eegan/Phys439-alpha-lab/README.md

# Phys439-alpha-lab
Arduino code and KiCAD schematic for McGill PHYS 439 lab setup
