eegan/Phys439-alpha-lab/doc/PHYS 439 alpha lab shield schematic.pdf

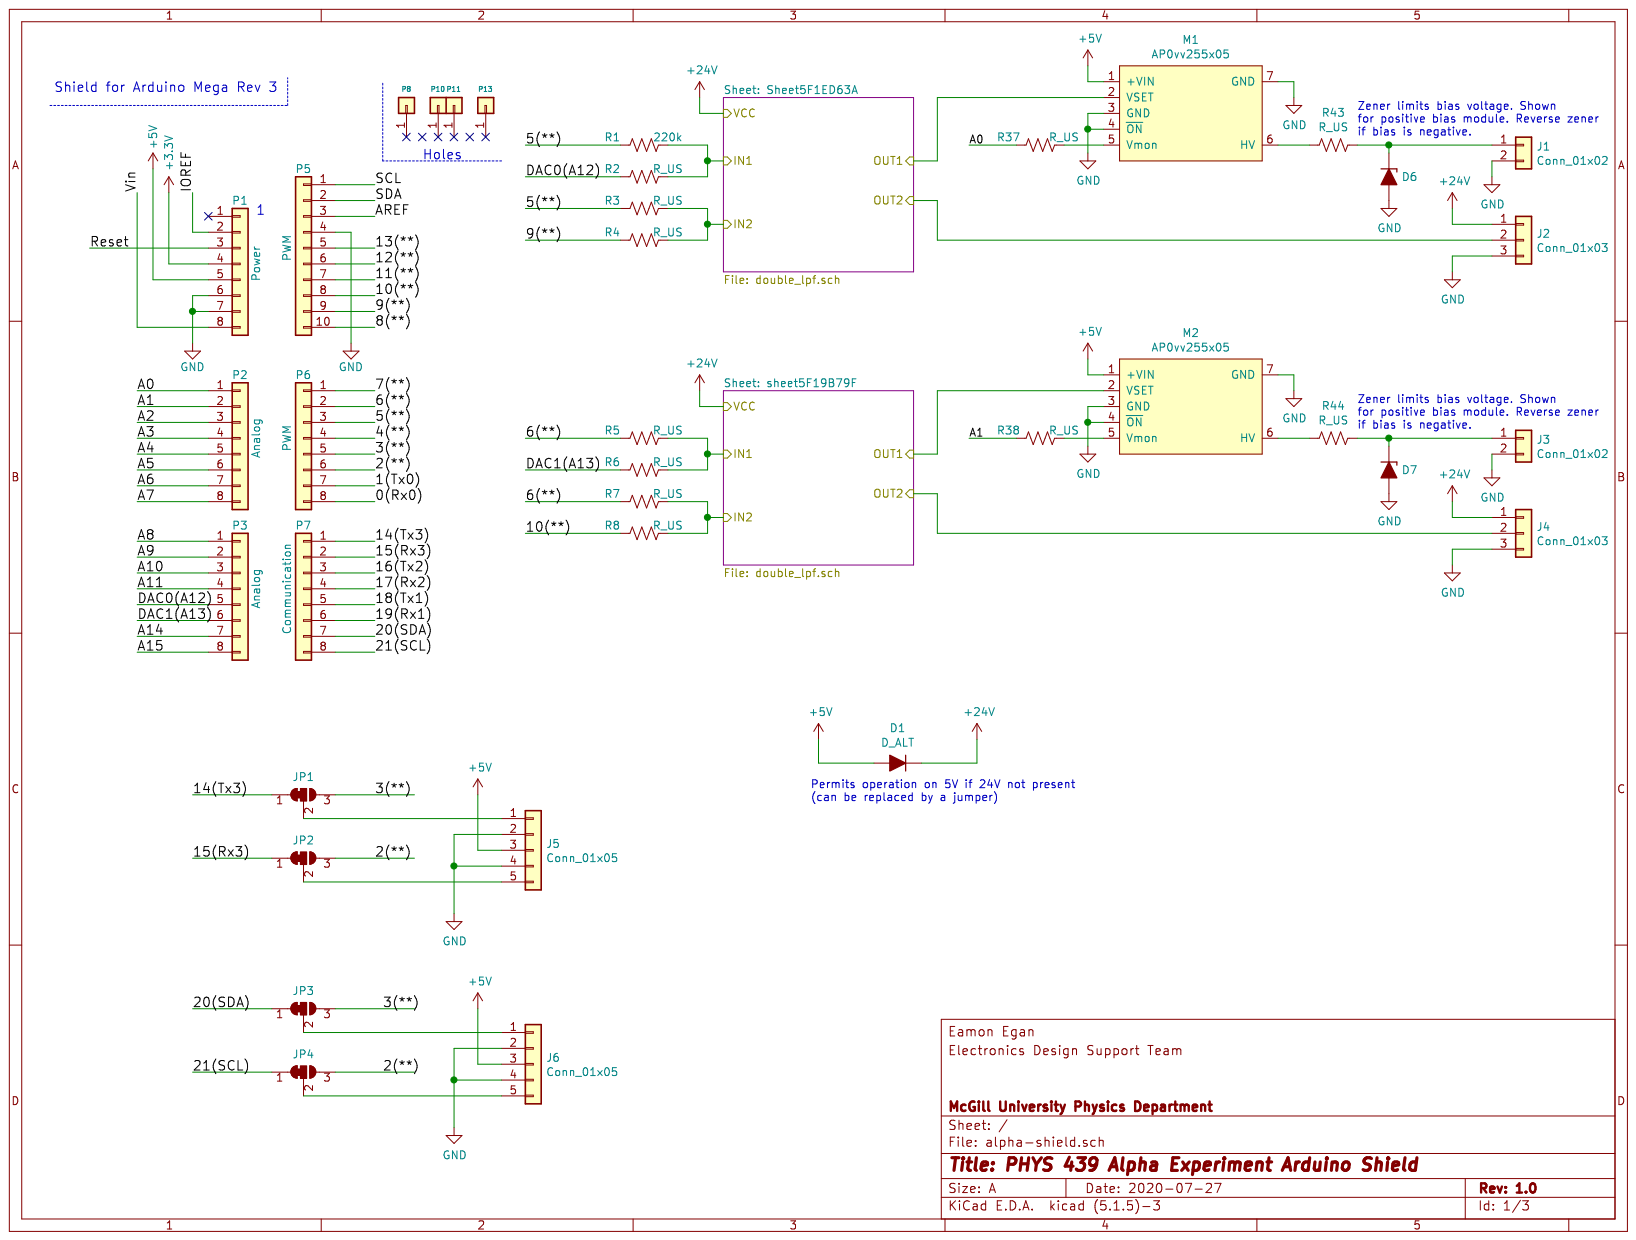
[picture p3: page 1]

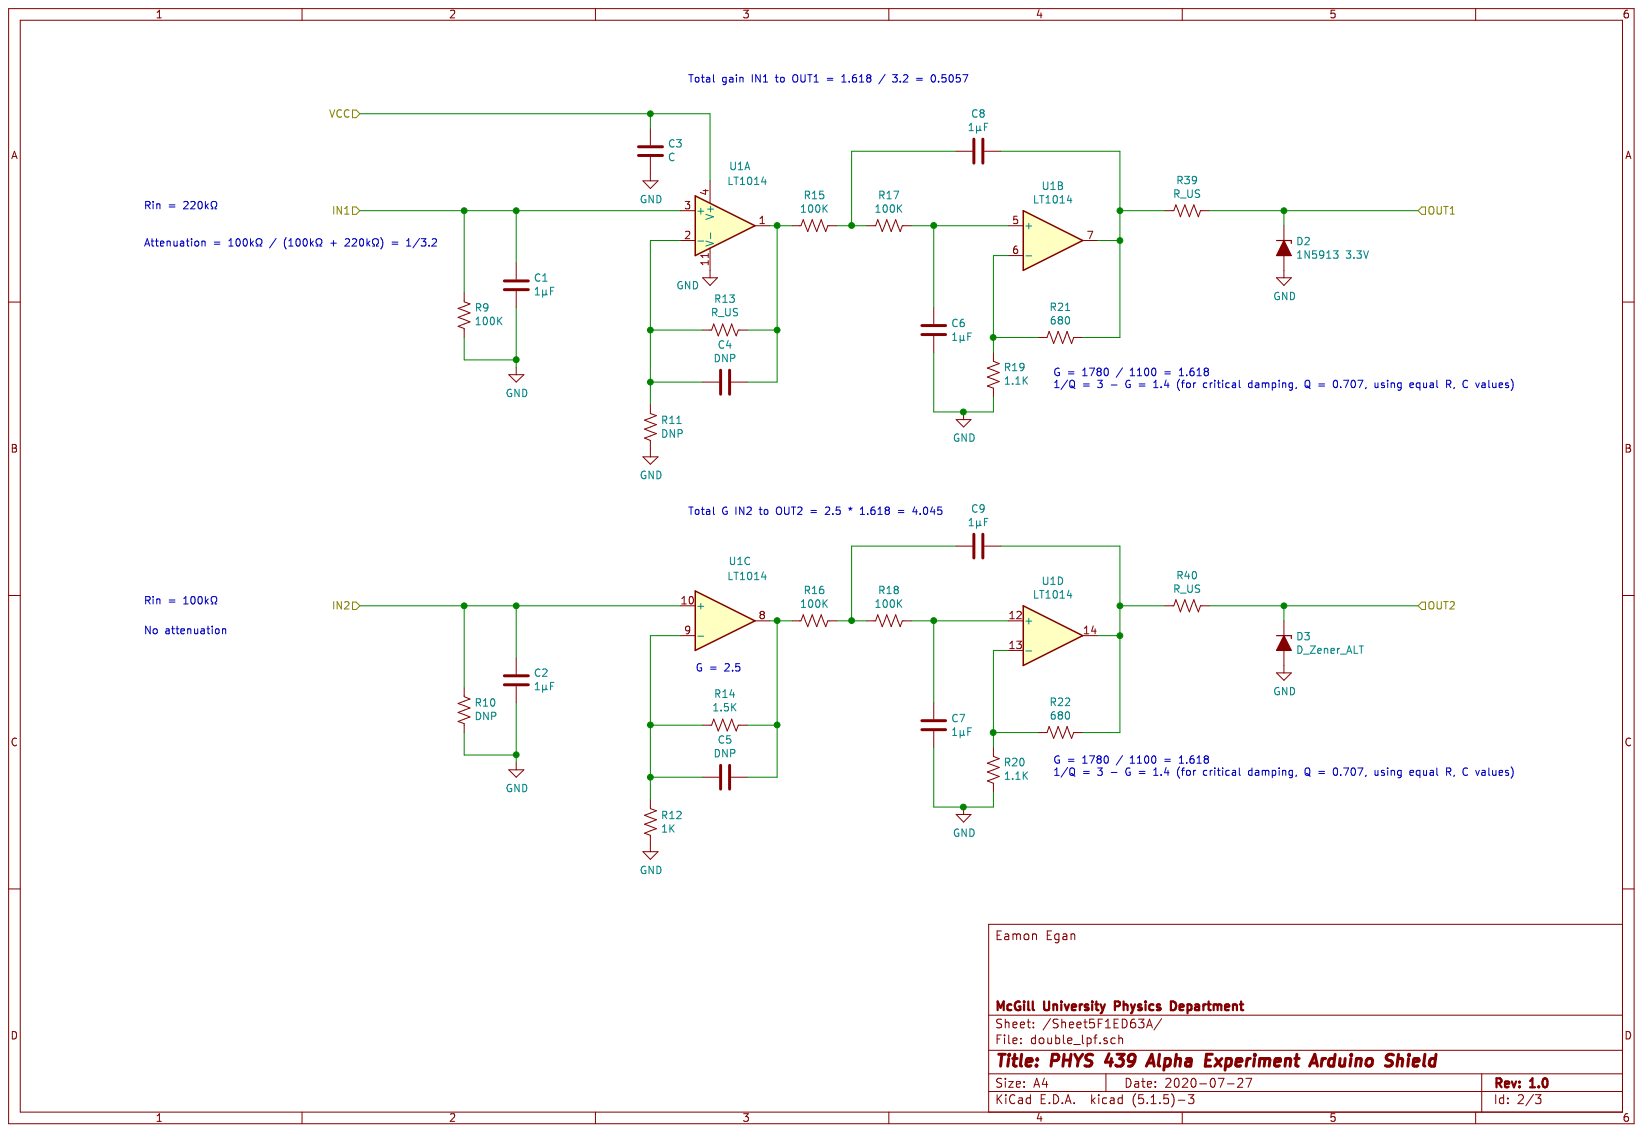
[picture p4: page 2]

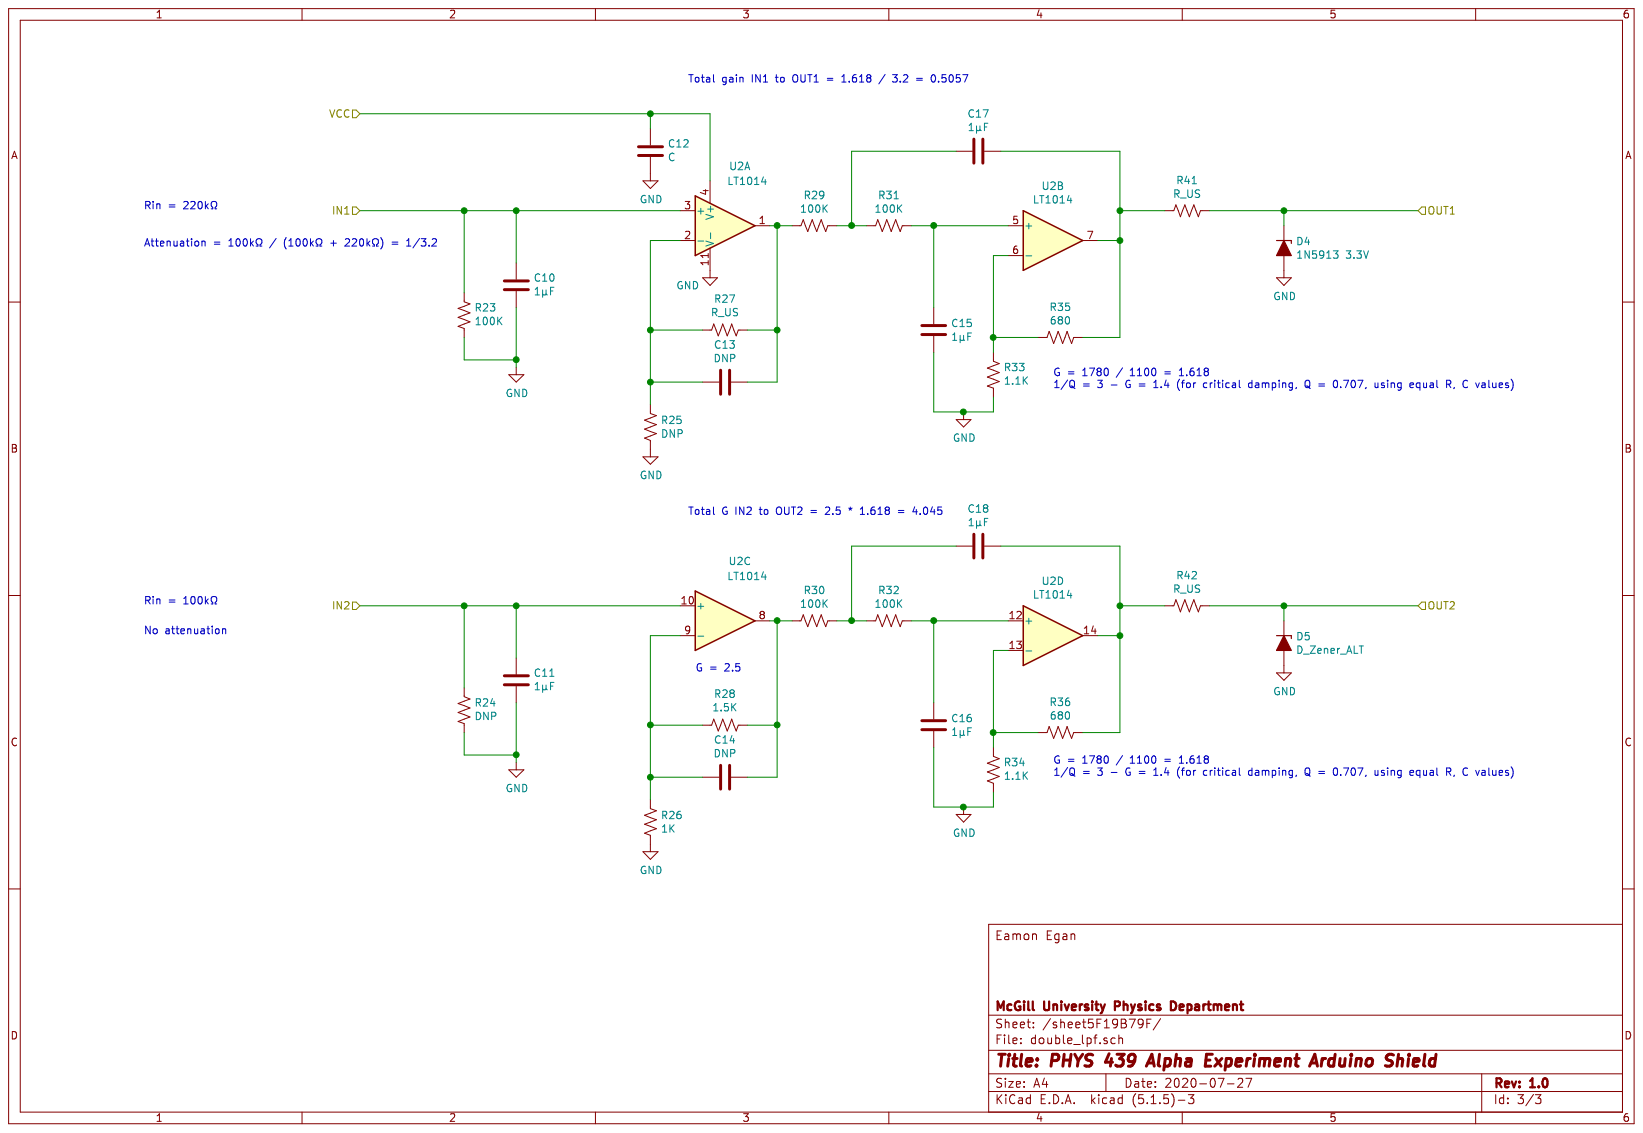
[picture p5: page 3]
