eegan/Phys439-alpha-lab/circuit/sim/PHYS439-alpha-filter.asc

C1: cap; 0
C2: cap; 1µF
C3: cap; {csk}
C4: cap; {csk}
R1: res; 1k
R2: res; 1G
R3: res; 220k
R4: res; 100k
R5: res; 1100
R6: res; 680
R7: res; {rsk}
R8: res; {rsk}
U1: LT1014D
U2: LT1014D
V1: voltage; 24
V2: voltage; 2; AC 1
Named nets: 0, out
.param csk=1u rsk=100k
.ac dec 500 0.1 1meg
.tran 5
