eegan/Phys439-alpha-lab/circuit/alpha-shield-pcb/alpha-shield.kicad_pcb

## KiCad design circuit/alpha-shield-pcb/alpha-shield.kicad_pcb (2020-08-14)

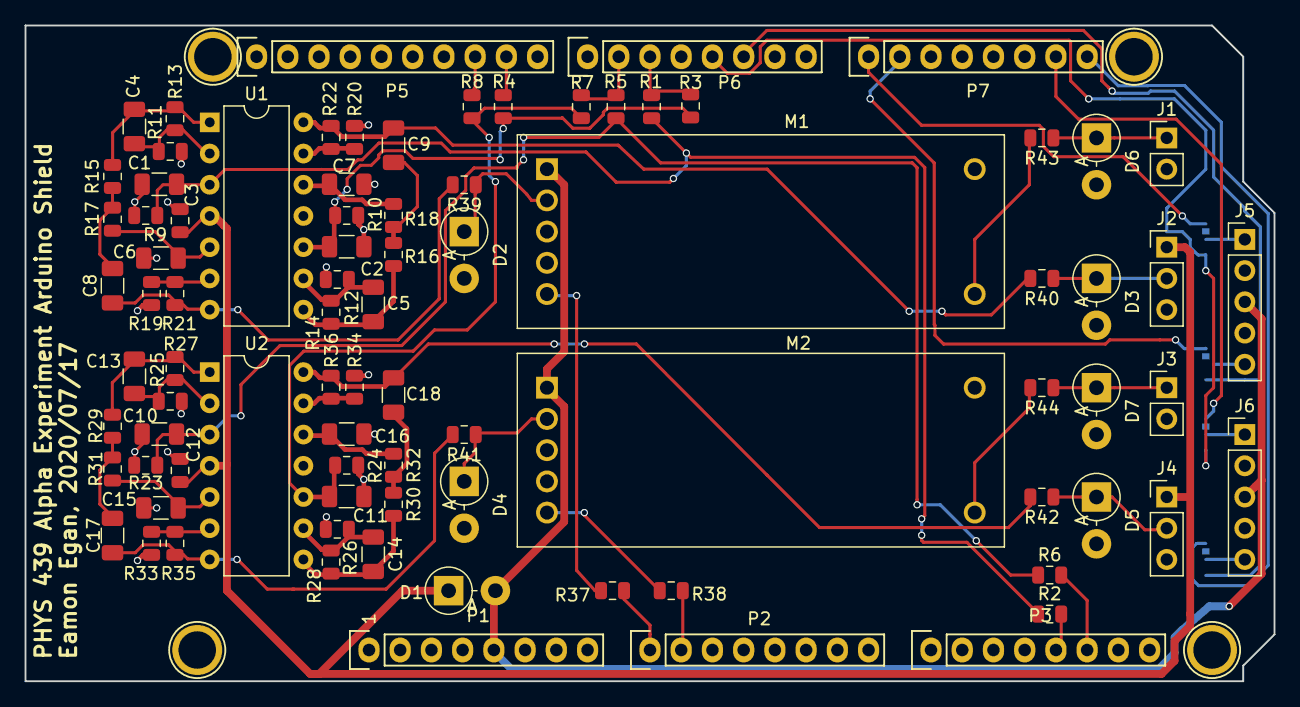
[picture p6: board alpha-shield.kicad_pcb from above]

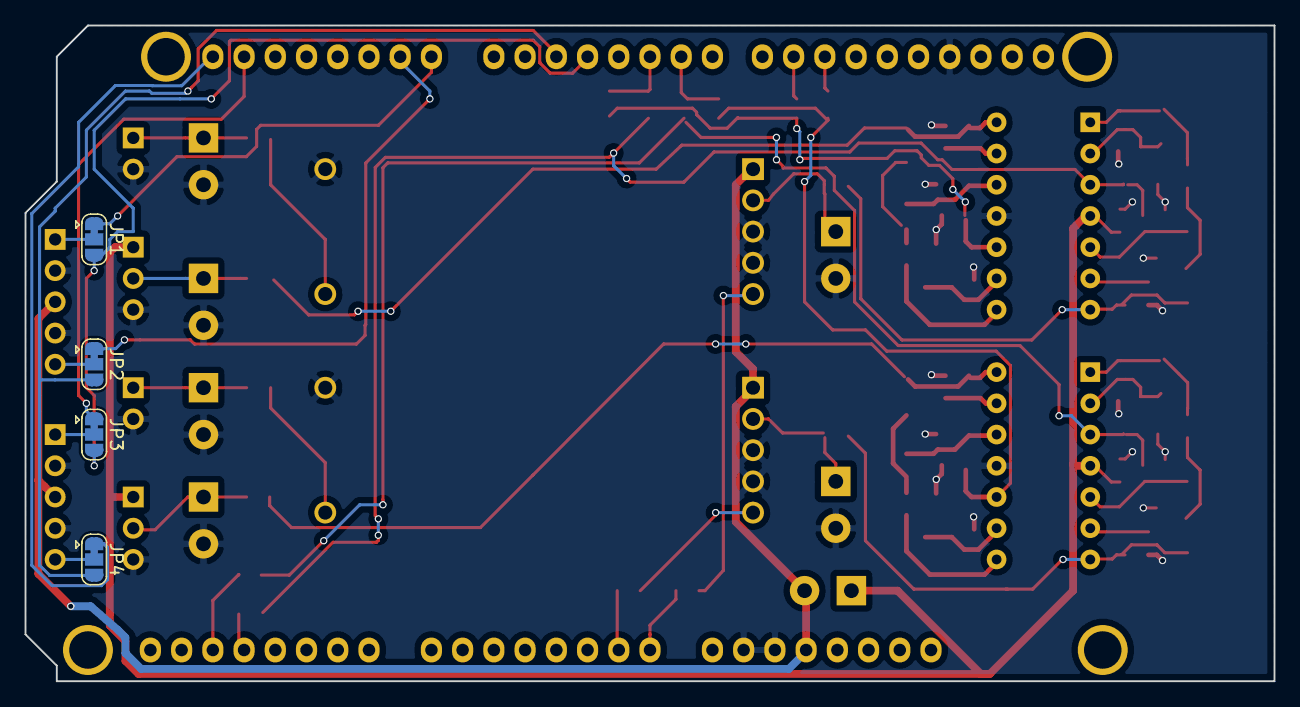
[picture p7: board alpha-shield.kicad_pcb from below]

Board: 2 copper layers, 101.6 x 53.3 mm, 93 parts (4 on the bottom side), 59 nets.

Parts:
C1, C2, C4, C5, C6, C7, C8, C9, C10, C11, C13, C14, C15, C16, C17, C18: C; C_1206_3216Metric
C3, C12: C; C_0805_2012Metric
D1: D_ALT; D_DO-15_P3.81mm_Vertical_AnodeUp
D2, D3, D4, D5, D6, D7: D_Zener_ALT; D_DO-15_P3.81mm_Vertical_AnodeUp
J1, J3: Conn_01x02; PinHeader_1x02_P2.54mm_Vertical
J2, J4: Conn_01x03; PinHeader_1x03_P2.54mm_Vertical
J5, J6: Conn_01x05; PinHeader_1x05_P2.54mm_Vertical
JP1, JP2, JP3, JP4: SolderJumper_3_Bridged12; SolderJumper-3_P1.3mm_Bridged12_RoundedPad1.0x1.5mm
M1, M2: AP0vv255x05; ISEG_HV_MODULE
P1: Power; Socket_Strip_Arduino_1x08
P2, P3: Analog; Socket_Strip_Arduino_1x08
P5: PWM; Socket_Strip_Arduino_1x10
P6: PWM; Socket_Strip_Arduino_1x08
P7: Communication; Socket_Strip_Arduino_1x08
P8, P10, P11, P13: CONN_01X01; Arduino_1pin
R1, R2, R3, R4, R5, R6, R7, R8, R9, R10, R11, R12, R13, R14, R15, R16, R17, R18, R19, R20, R21, R22, R23, R24, R25, R26, R27, R28, R29, R30, R31, R32, R33, R34, R35, R36, R37, R38, R39, R40, R41, R42, R43, R44: R_US; R_0805_2012Metric
U1, U2: LT1014; DIP-14_W7.62mm

Connections:
+5V: D1.2, J5.3, J6.3, M1.1, M2.1, P1.5
+24V: C3.2, C12.2, D1.1, J2.1, J4.1, U1.4, U2.4
/2(**): JP2.3, JP4.3, P6.6
/3(**): JP1.3, JP3.3, P6.5
/5(**): P6.3, R1.2, R3.2
/6(**): P6.2, R5.2, R7.2
/9(**): P5.9, R4.2
/10(**): P5.8, R8.2
/14(Tx3): JP1.1, P7.1
/15(Rx3): JP2.1, P7.2
/20(SDA): JP3.1, P7.7
/21(SCL): JP4.1, P7.8
/A0: P2.1, R37.2
/A1: P2.2, R38.2
/DAC0(A12): P3.5, R2.2
/DAC1(A13): P3.6, R6.2
/Sheet5F1ED63A/IN1: C1.2, R1.1, R2.1, R9.2, U1.3
/Sheet5F1ED63A/IN2: C2.2, R3.1, R4.1, R10.2, U1.10
/Sheet5F1ED63A/OUT1: D2.1, M1.2, R39.1
/Sheet5F1ED63A/OUT2: D3.1, J2.2, R40.1
/sheet5F19B79F/IN1: C10.2, R5.1, R6.1, R23.2, U2.3
/sheet5F19B79F/IN2: C11.2, R7.1, R8.1, R24.2, U2.10
/sheet5F19B79F/OUT1: D4.1, M2.2, R41.1
/sheet5F19B79F/OUT2: D5.1, J4.2, R42.1
GND: C1.1, C2.1, C3.1, C6.2, C7.2, C10.1, C11.1, C12.1, C15.2, C16.2, D2.2, D3.2, D4.2, D5.2, D6.2, D7.2, J1.2, J2.3, J3.2, J4.3, J5.2, J5.4, J6.2, J6.4, M1.3, M1.4, M1.7, M2.3, M2.4, M2.7, P1.6, P1.7, P5.4, R9.1, R10.1, R11.2, R12.2, R19.1, R20.1, R23.1, R24.1, R25.2, R26.2, R33.1, R34.1, U1.11, U2.11
unnamed: C4.1, R13.2, R15.2, U1.1
unnamed: C4.2, R11.1, R13.1, U1.2
unnamed: C5.1, R14.2, R16.2, U1.8
unnamed: C5.2, R12.1, R14.1, U1.9
unnamed: C6.1, R17.1, U1.5
unnamed: C7.1, R18.1, U1.12
unnamed: C8.1, R21.1, R39.2, U1.7
unnamed: C8.2, R15.1, R17.2
unnamed: C9.1, R22.1, R40.2, U1.14
unnamed: C9.2, R16.1, R18.2
unnamed: C13.1, R27.2, R29.2, U2.1
unnamed: C13.2, R25.1, R27.1, U2.2
unnamed: C14.1, R28.2, R30.2, U2.8
unnamed: C14.2, R26.1, R28.1, U2.9
unnamed: C15.1, R31.1, U2.5
unnamed: C16.1, R32.1, U2.12
unnamed: C17.1, R35.1, R41.2, U2.7
unnamed: C17.2, R29.1, R31.2
unnamed: C18.1, R36.1, R42.2, U2.14
unnamed: C18.2, R30.1, R32.2
unnamed: D6.1, J1.1, R43.1
unnamed: D7.1, J3.1, R44.1
unnamed: J5.1, JP1.2
unnamed: J5.5, JP2.2
unnamed: J6.1, JP3.2
unnamed: J6.5, JP4.2
unnamed: M1.5, R37.1
unnamed: M1.6, R43.2
unnamed: M2.5, R38.1
unnamed: M2.6, R44.2
unnamed: R19.2, R21.2, U1.6
unnamed: R20.2, R22.2, U1.13
unnamed: R33.2, R35.2, U2.6
unnamed: R34.2, R36.2, U2.13
