eegan/Phys439-alpha-lab/(commit log)

2020-07-30 Adapt it to the Due, use only 12 bit PWMs
2020-08-02 setting calculations fixed to include 3.3V VCC and calculated circuit gains.
    [alpha-shield.ino]
2020-08-03 Debug relays
2020-08-03 modify README to reference KiCAD schematic, and move stuff into code folder
2020-08-03 move code down into arduino project-name folder
2020-08-04 Add in offset (get ready for calibration). Put in option for using native serial port.
2020-08-05 Add bias control, and approximate offset for valve transistor Vbe
2020-08-07 revise to-do list, fix Dbg (Serial2) reference
    [alpha-shield.ino]
2020-08-08 program hanging bug fixed: comment out "Dbg.print" (sent to Serial2)
    [alpha-shield.ino]
2020-08-08 Add READ1? READ2? READ3? command, to read A0, A1, A2 pins. READ1 reads the bias voltage monitor pin, READ2 reads a 4:1 divider Values returned should be 12 bit ADC counts.
2020-08-12 Added pressure conversion and pressure readout command
2020-08-14 Add full project including KiCAD design, part data sheets, simulation
    [PWMFilter.sch, alpha-shield.kicad_pcb, alpha-shield.sch, bias_supply.sch, double_lpf.sch]
2020-08-14 Add revision block, component values, prior to showing board mods
    [alpha-shield.sch, double_lpf.sch]
2020-08-14 Add board modifications, update to 1.0a
    [alpha-shield.sch, double_lpf.sch]
2020-08-17 Fixed the conversion factor
    [alpha-shield.ino]
2020-08-20 Minor changes with voltage divider conversion factor
2020-08-26 Fixed ADC voltage readout commands
    [alpha-shield.ino]
2020-08-26 Working on PWM commands
2020-08-26 Fixed PWM set commands
    [alpha-shield.ino]
2020-08-26 fix pwm raw write, clean up a couple of things
    [alpha-shield.ino]
2020-08-26 Add raw PWM readback function
2020-08-26 Fix bug in GetPWM (channel 1 always read back, thanks Megan)
    [alpha-shield.ino]
2020-08-27 Fix type conversion in SetPWM (toInt -> toFloat)
    [alpha-shield.ino]
2020-08-28 Possible fix for pressure readback issue; will test in lab tomorrow
    [alpha-shield.ino]
2020-09-01 increase number of samples averaged; output 5 decimal places
2020-09-24 Extended VOLTAGEn? command to VOLTAGE8 Added VREF:ON, VREF:OFF, VREF:ONOFF 2.5V reference is read between VOLTAGE6 and VOLTAGE7
